etakerim/TableLamp/docs/VNOS-Semestrálny-projekt.pdf

## Inteligentné osvetlenie stola

Bc. Miroslav Hájek

Semestrálny projekt

Vnorené systémy, FIIT STU | 2022 / 2023

Špecifikácia požiadaviek | 2

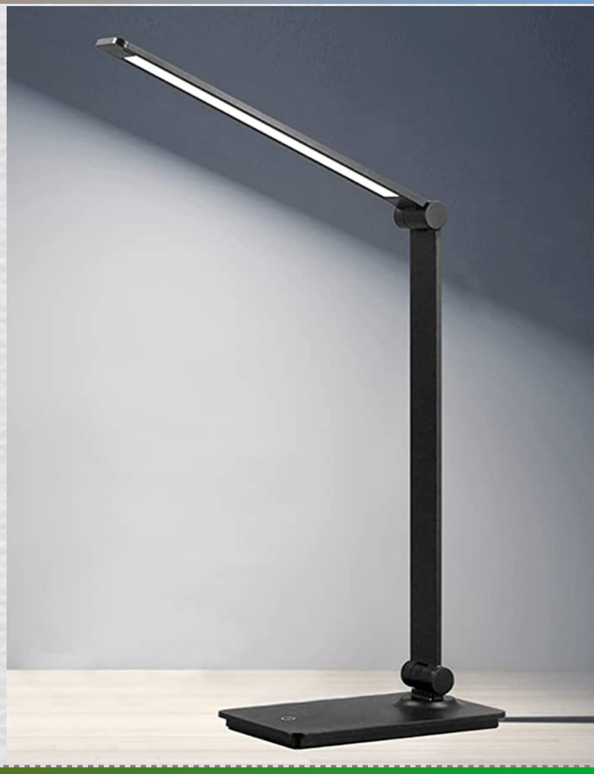
[picture p16: figure]

Svietidlo s MCU ESP32.

- Osvetlenie celého povrchu pracovného stola.
- Zapnutie svetla pri slabom osvetlení a detekcii pohybu.
- Zachovanie nastavení svietidla medzi zapnutiami.

Mobilná aplikácia na Android cez Bluetooth

- Vypnúť / Zapnúť svetlo
- Farebná teplota (K)
- Jas (%)
- Prahová úroveň pre slabé osvetlenie (Lux)

Periférne zariadenia | 3

### Senzory

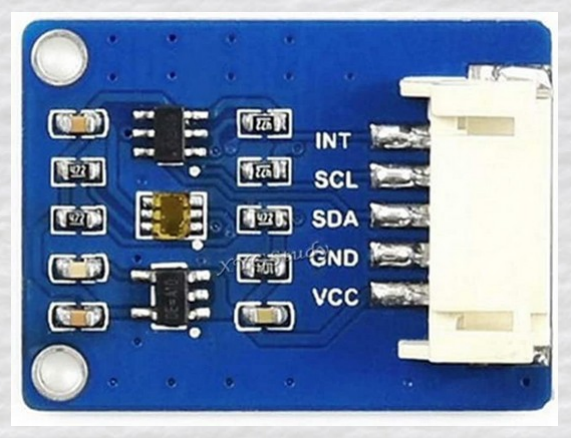
[picture p17: figure]

Senzor osvetlenia (I2C)

TSL25911FN

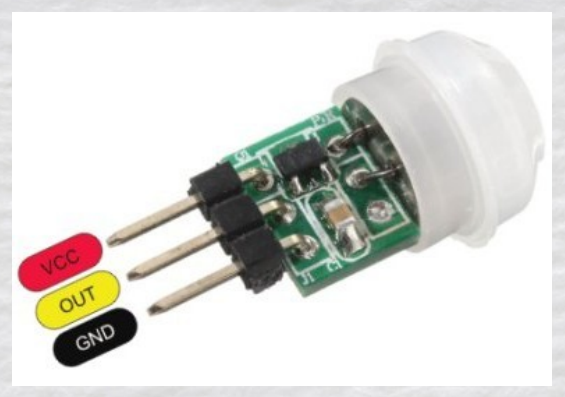
[picture p18: figure]

Senzor pohybu PIR (GPIO)

SB312

### Komunikácia

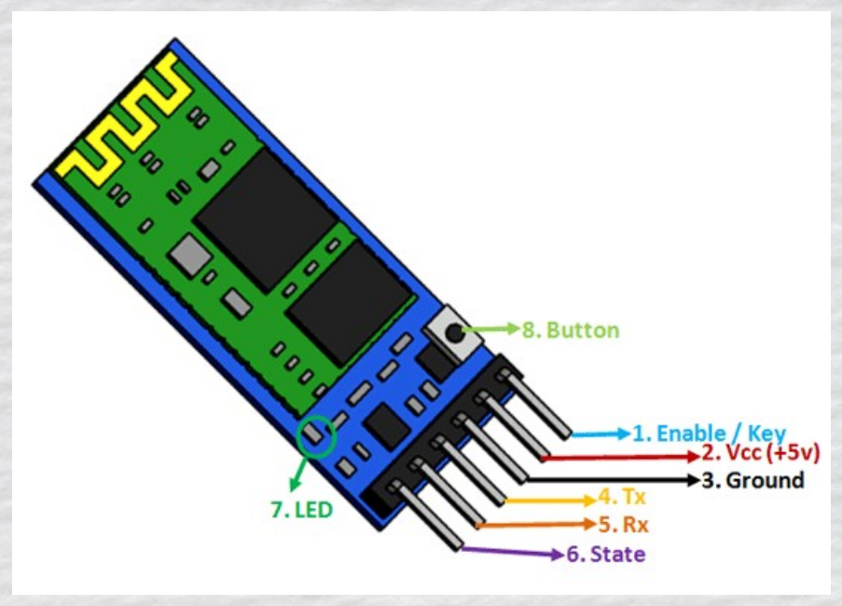
[picture p19: figure]

Bluetooth vysielač-

prijímač (UART)

HC-05

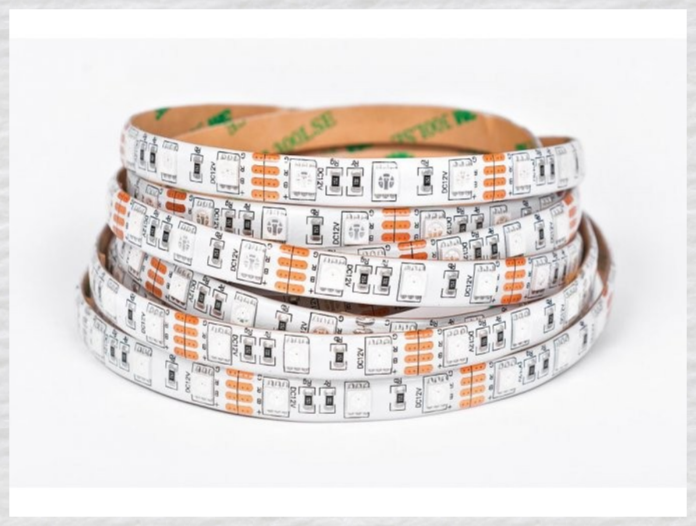
[picture p20: figure]

RGB LED pásik

12 V, 14,4 W/m, 60 LED/ m

### Akčné členy

Vývojová doska ESP32 Lolin D32 | 4

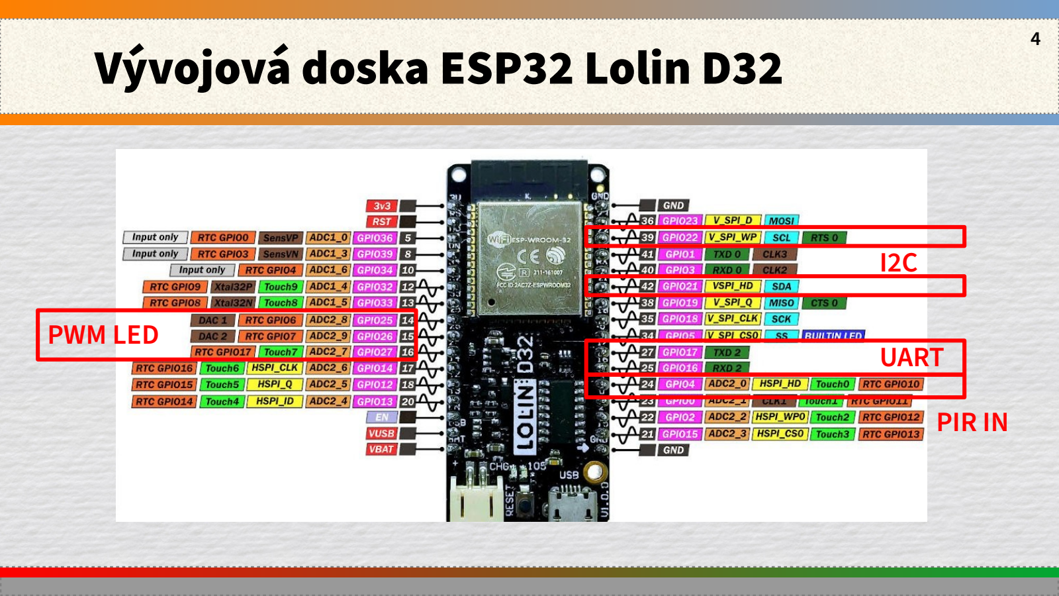
[picture p21: page 4]

I2C

UART

PIR IN

PWM LED

Bloková a elektrická schéma | 5

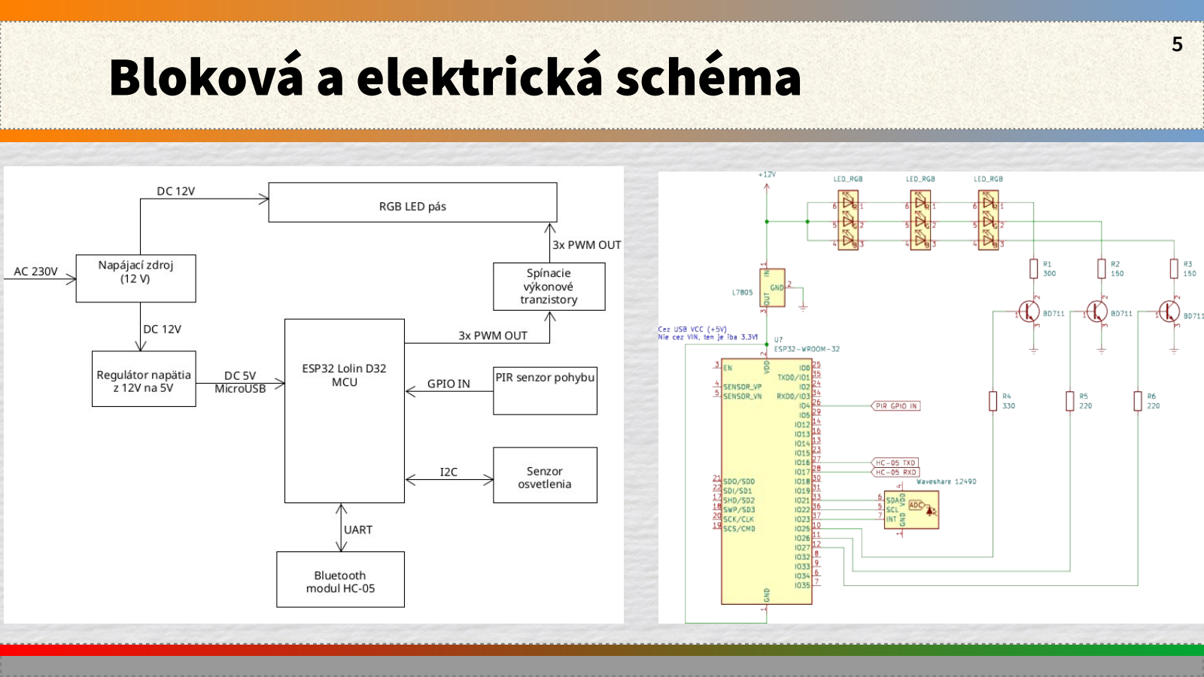
[picture p22: page 5]

Hardvér - kontroler svietidla | 6

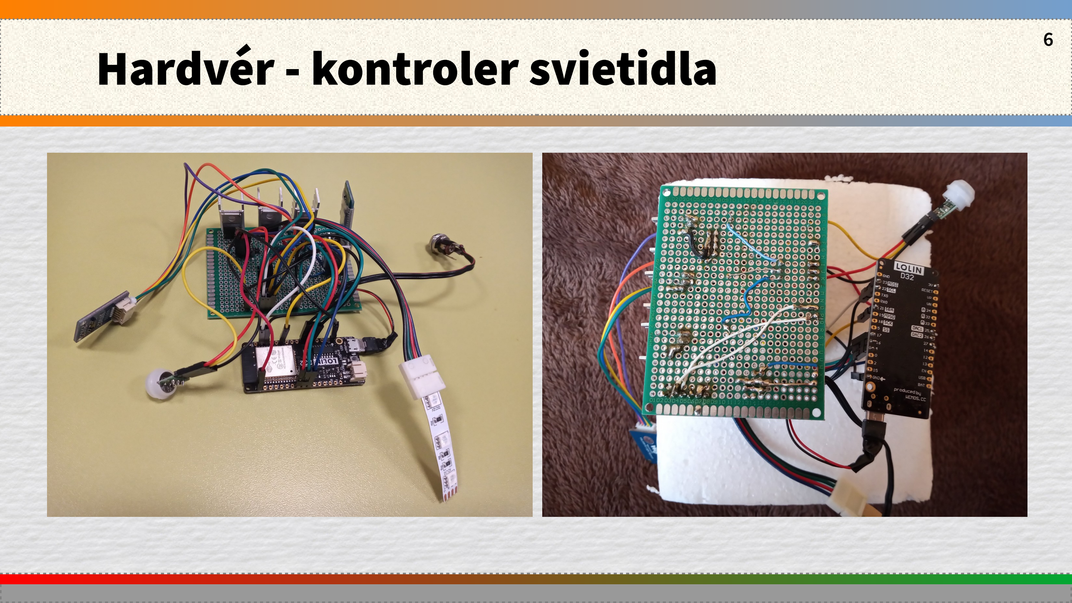
[picture p23: page 6]

Pravidlá na spínanie svetla | 7

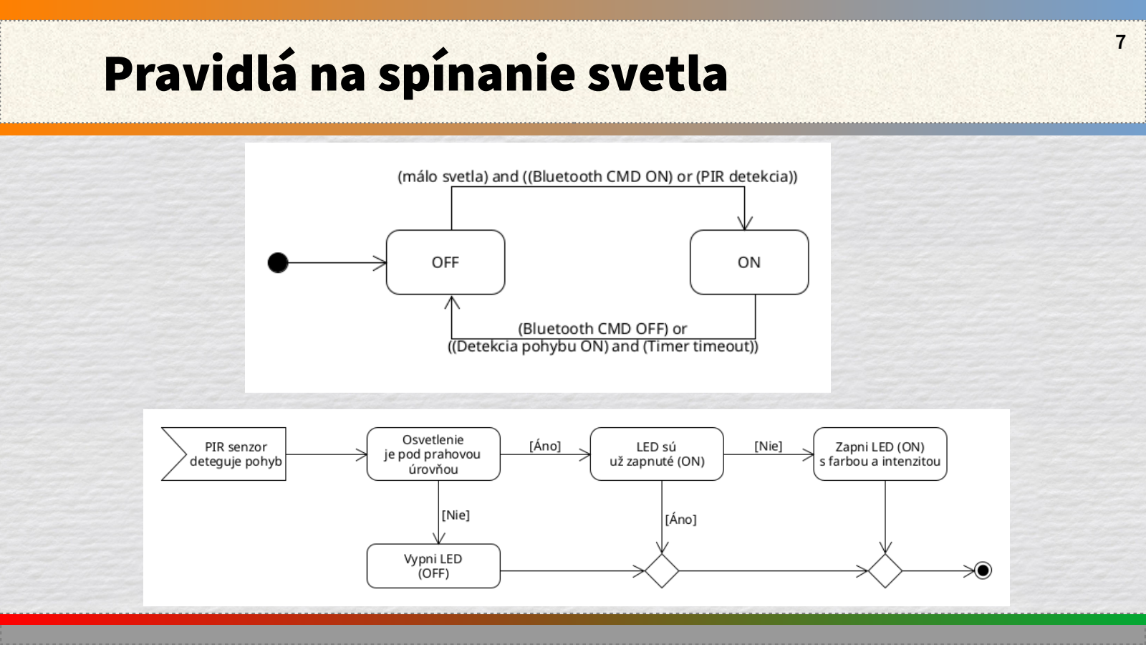
[picture p24: page 7]

Komunikácia úloh firmvéru | 8

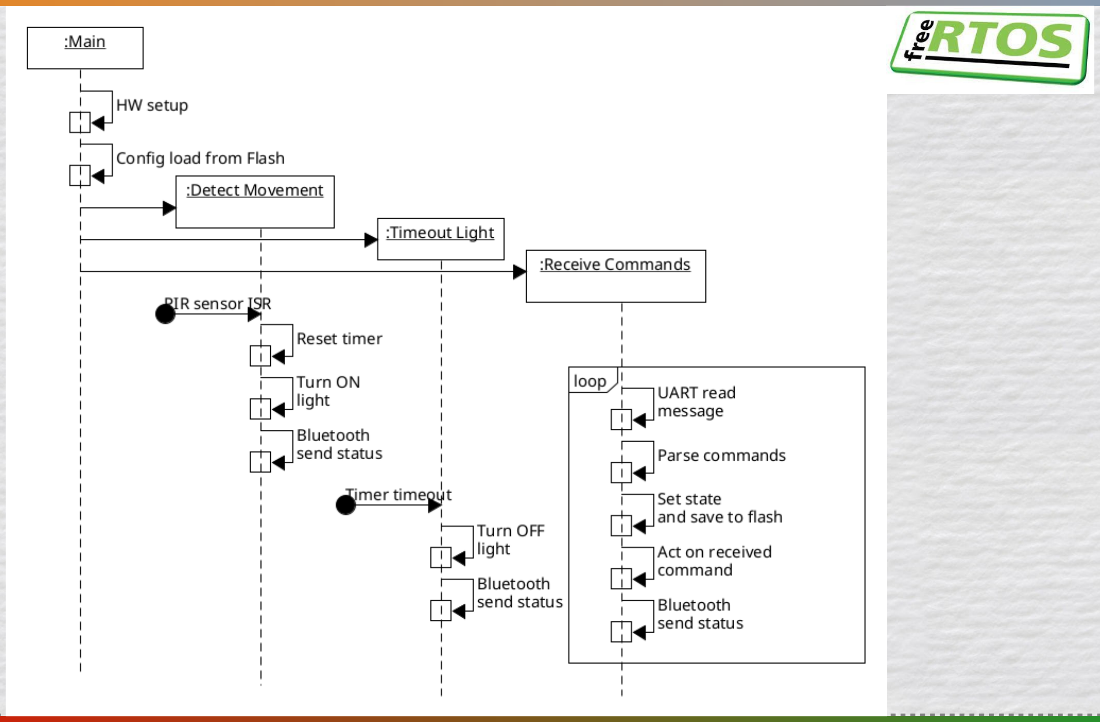
[picture p25: figure]

Úloha spínania svetla | 9

## typedef struct {

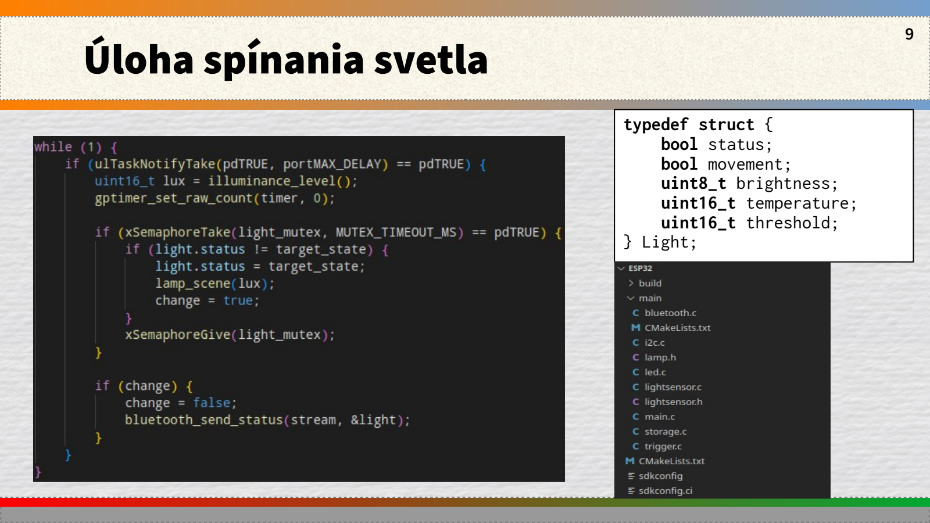
[picture p26: page 9]

bool status;
bool movement;
uint8_t brightness;
uint16_t temperature;
uint16_t threshold;
} Light;

Mobilná aplikácia | 10

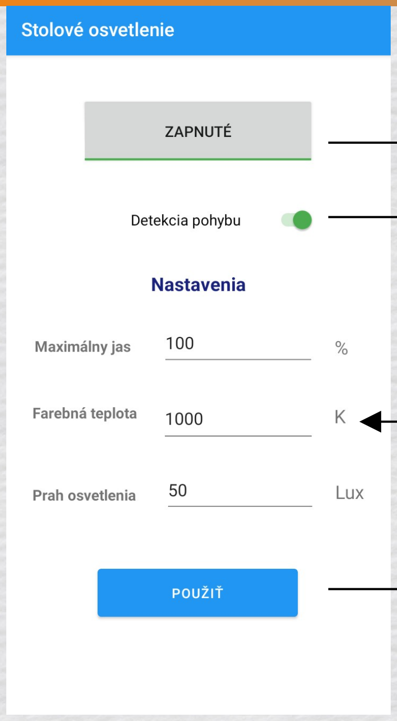
[picture p27: figure]

Bluetooth RFCOMM príkazy

SWITCH

DETECT

LEVEL 100, KELVIN 1000, LUX 50

{S/1,M/1,K/1000,B/100/L/50}

Pri zmene nastavení svetla

Rozsahy: 0 – 100, 1000 – 40000, 0 - 10000

Akceptačné testy | 11

#1: Opakované nadväzovanie Bluetooth spojenia

#2: Aktívna detekcia pohybu

#3: Deaktivovaná detekcia pohybu

#4: Manuálne zapnutie a vypnutie svetla

#5: Zmena farebnej teploty svetla

#6: Zmena jasu svetla

#7: Reakcia svetla na okolité osvetlenie

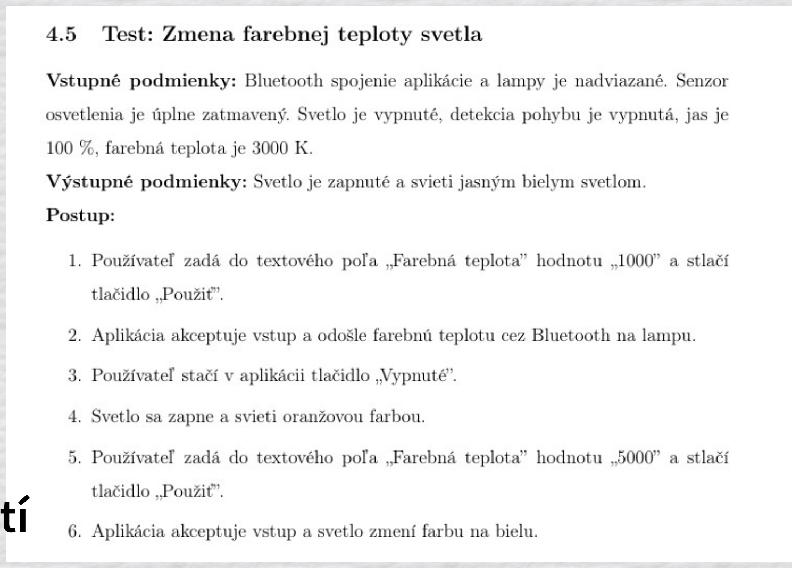
[picture p28: figure]

#8: Načítanie pôvodných nastavení po zapnutí

Vnorený systém svietidla | 12

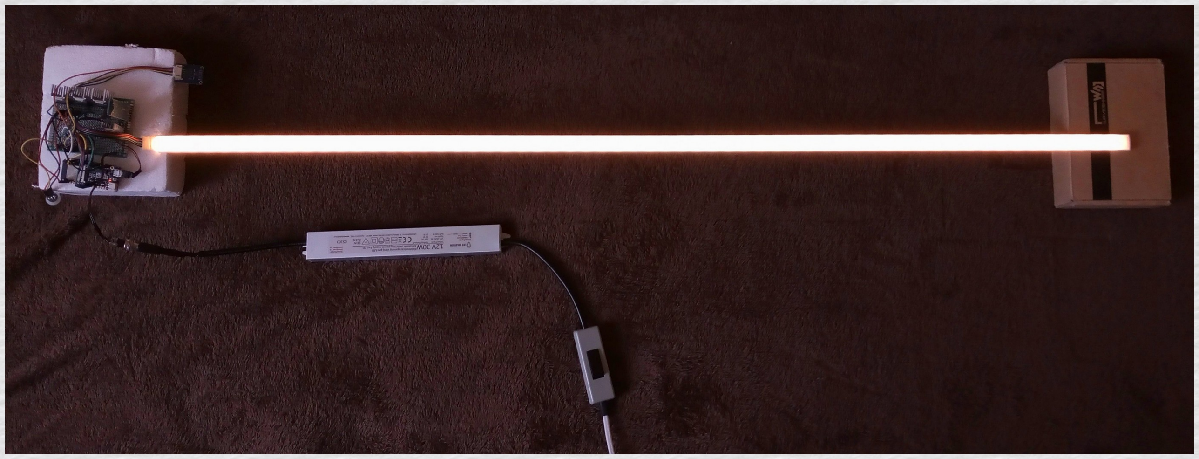
[picture p29: figure]
