etakerim/TableLamp/docs/assets/ilustrative-lamp.jpg

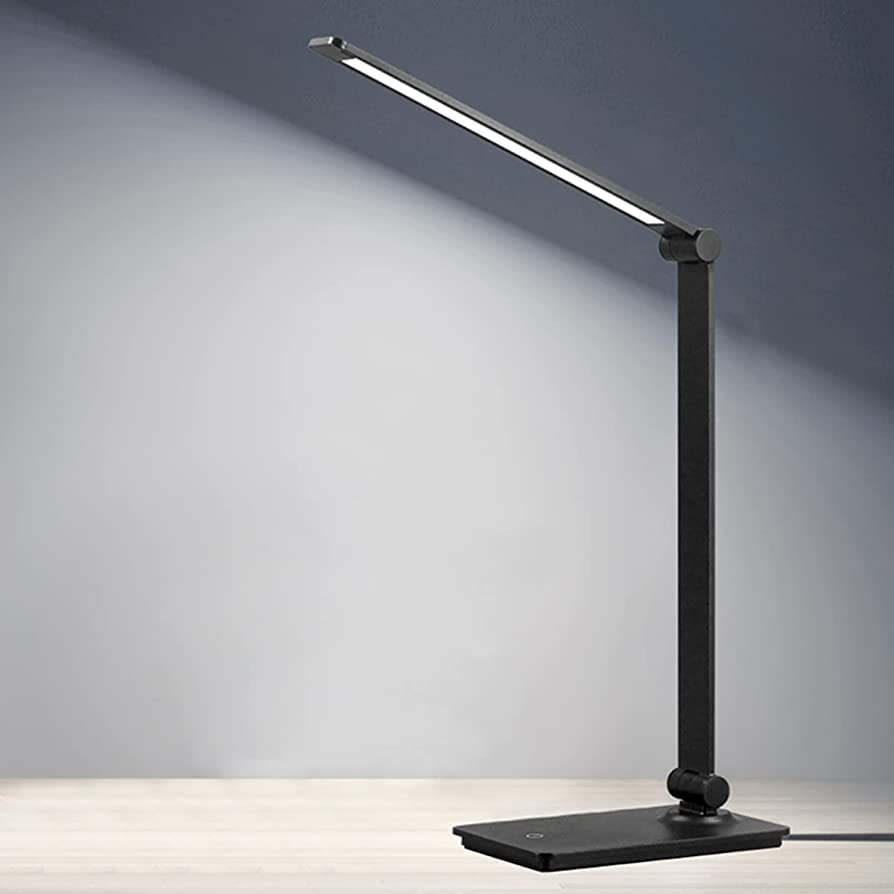
docs/assets/ilustrative-lamp.jpg
