etakerim/TableLamp/docs/assets/light-sensor.jpg

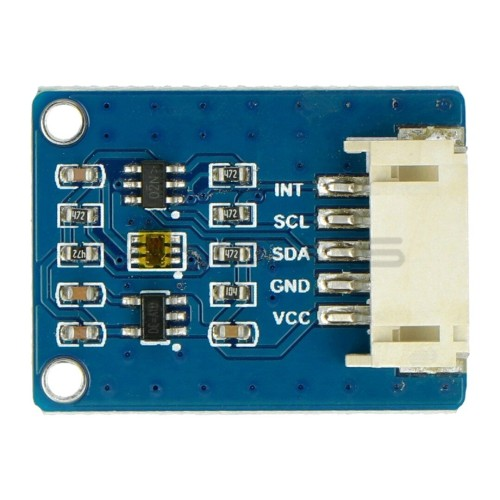
docs/assets/light-sensor.jpg
