etakerim/TableLamp/docs/assets/tasks.png

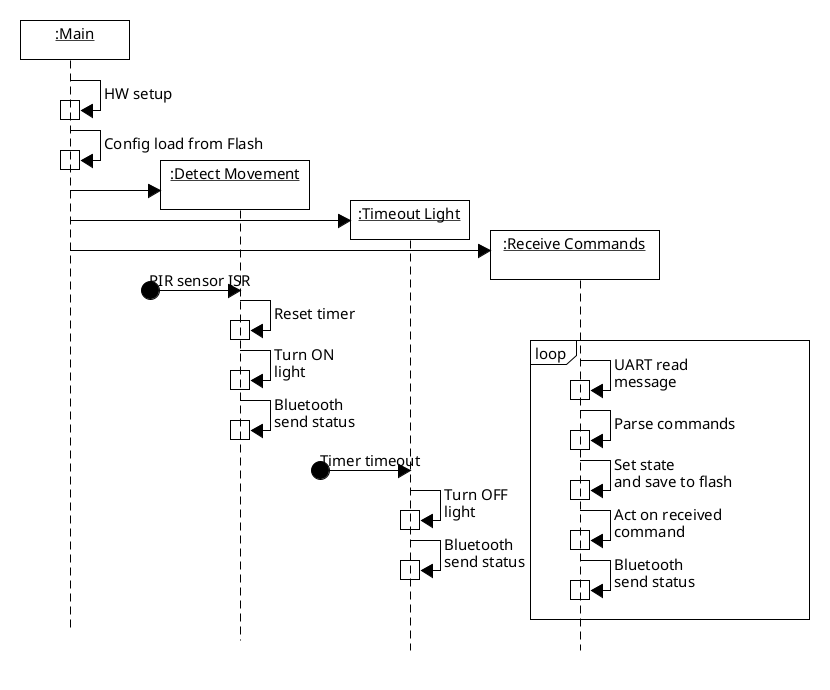
docs/assets/tasks.png
