etakerim/TableLamp/schematics-bkp/TableLamp.kicad_sch

## KiCad design schematics-bkp/TableLamp.kicad_sch (2023-03-17, last stored version)

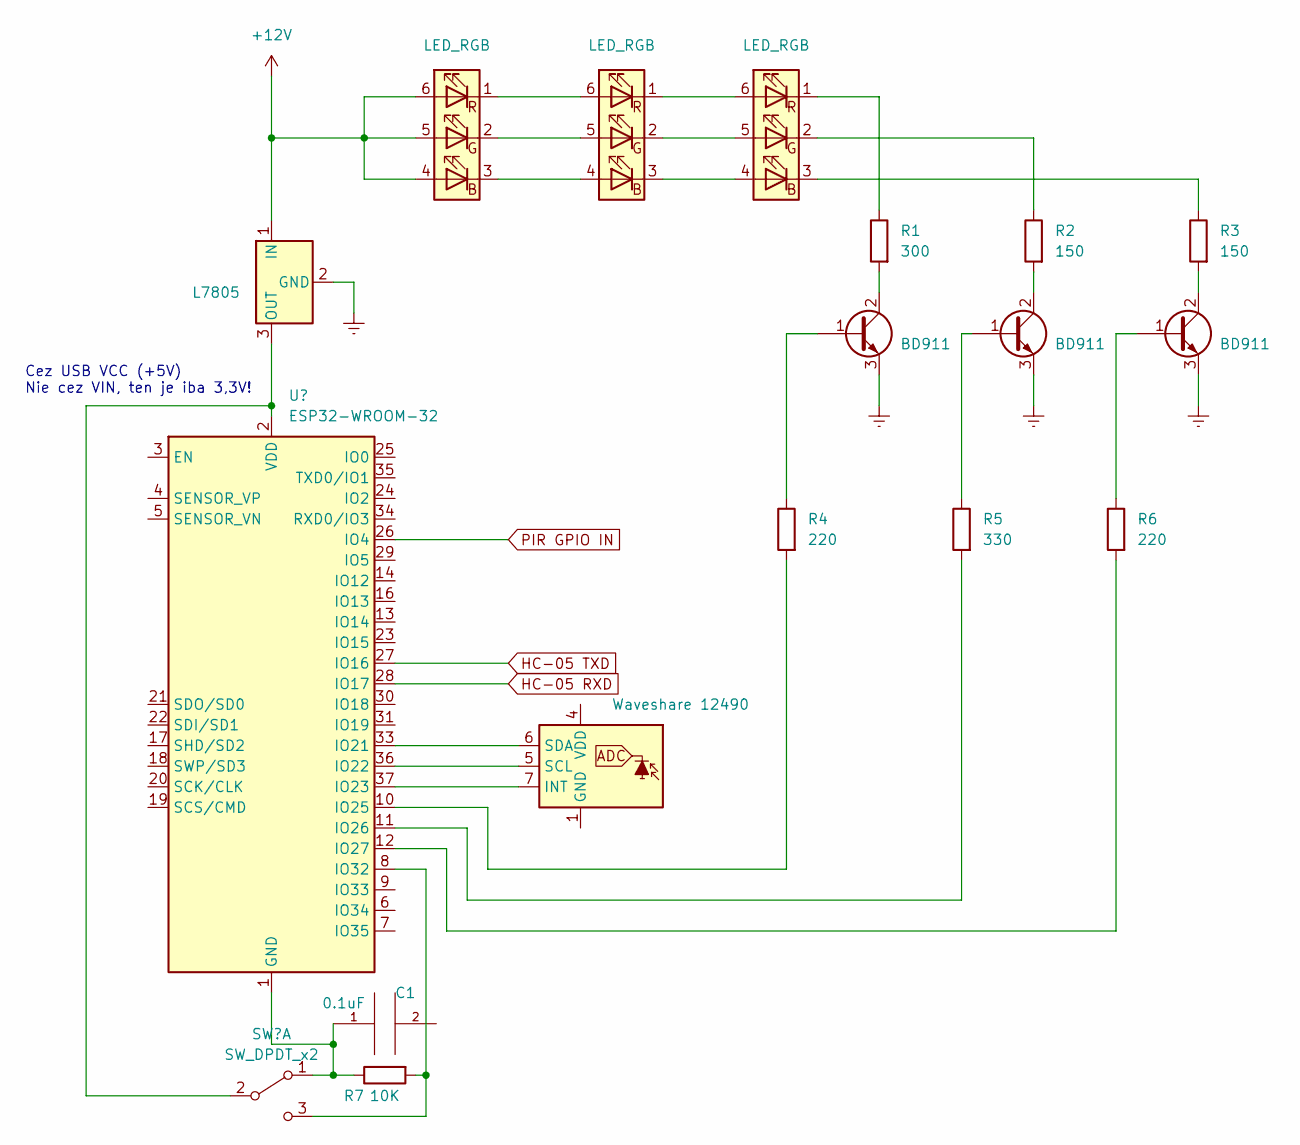
[picture p40: schematic TableLamp.kicad_sch]

Parts:
C1: 0.1uF
R1: 300
R2, R3: 150
R4, R6: 220
R5: 330
R7: 10K

Connections:
unnamed: C1.1, R7.1

Notes on the sheet:
Cez USB VCC (+5V) Nie cez VIN, ten je iba 3,3V!
