etakerim/TableLamp/(commit log)

2023-03-17 Start with untested prototype version of apps
    [TableLamp.kicad_pcb, TableLamp.kicad_sch]
2023-03-19 Switch light with PIR sensor and turn off with timer
2023-04-10 Android app bluetooth flow
    [TableLamp.kicad_pcb, TableLamp.kicad_sch]
2023-04-11 Send commands via BT to light
    [TableLamp.kicad_pcb, TableLamp.kicad_sch]
2023-04-12 Fix i2c light sensor driver
    [i2c.c, lamp.h, lightsensor.c, lightsensor.h, main.c]
